analogdog/Source-Sink-Transistor-SST-/Rev6/SST6 bill of materials.xlsx

Component | Package | Value | Manuf | Manuf Part No | Distrib | Distrib Part No | Ref Name | Qty
2N7002 | SOT23 |  | On Semi | 2N7002NCT | Digikey | 2N7002NCT-ND | Q4 | 1
2SD1047 | to247 |  | STMicroelectronics | 2SD1047 | Digikey | 497-11320-5-ND | Q2 | 1
1206YG225ZATEA | SM1206 | 0.1uF | Kemet | C1206C104K3RACTU | Digikey | 399-8140-1-ND | C2 C3 C4 | 3
AAVID_HS_TO220 | SK129 |  | AAvid | 530002B02500G | Digikey | HS380-ND | HS1 | 1
CP1 | DSCV | 10uF | Nichion | RNS1E100MDS1 | Digikey | 493-14240-ND | C1 | 1
DG449 | SM |  | Vishay | DG449DS-T1-E3CT | Digikey | DG449DS-T1-E3CT-ND | U2 U3 | 2
IXDD604 | SM |  | IXYS | IXDD PI SIA | Digikey | CLA333-ND | U1 | 1
Molex 44068-06 | MISC |  | Molex | 440680002 | Digikey | 1727-2692-1-ND | J1 | 1
PBSS4041SPN | SOL |  | Nexperia | PBSS4041SPN,115 | Digikey | 1727-5110-1-ND | Q3 | 1
PMEG100V080 | SM |  | Nexperia | PMEG100V080 | Digikey | 1727-2692-1-ND | D1 D2 | 2
R SM1206 | SM | 10K | Stackpole | RMCF1210JT10K0CT | Digikey | RMCF1210JT10K0CT-ND | R2 R3 R4 | 3
R SM1206 | SM | 470 | Stackpole | RMCF1210JT470RCT | Digikey | RMCF1210JT470RCT-ND | R1 | 1
si4564DYPP | SOL |  | Vishay Siliconix | SI4564DY-T1-GE3CT-ND | Digikey | SI4564DY-T1-GE3CT-ND | Q1 | 1
 |  |  |  |  |  |  |  | 19
PCB Artist Bill of Materials is provided for reference only and must be verified by the user.
