analogdog/Source-Sink-Transistor-SST-/Rev6/pdf/Bottom PCB SST6.pdf

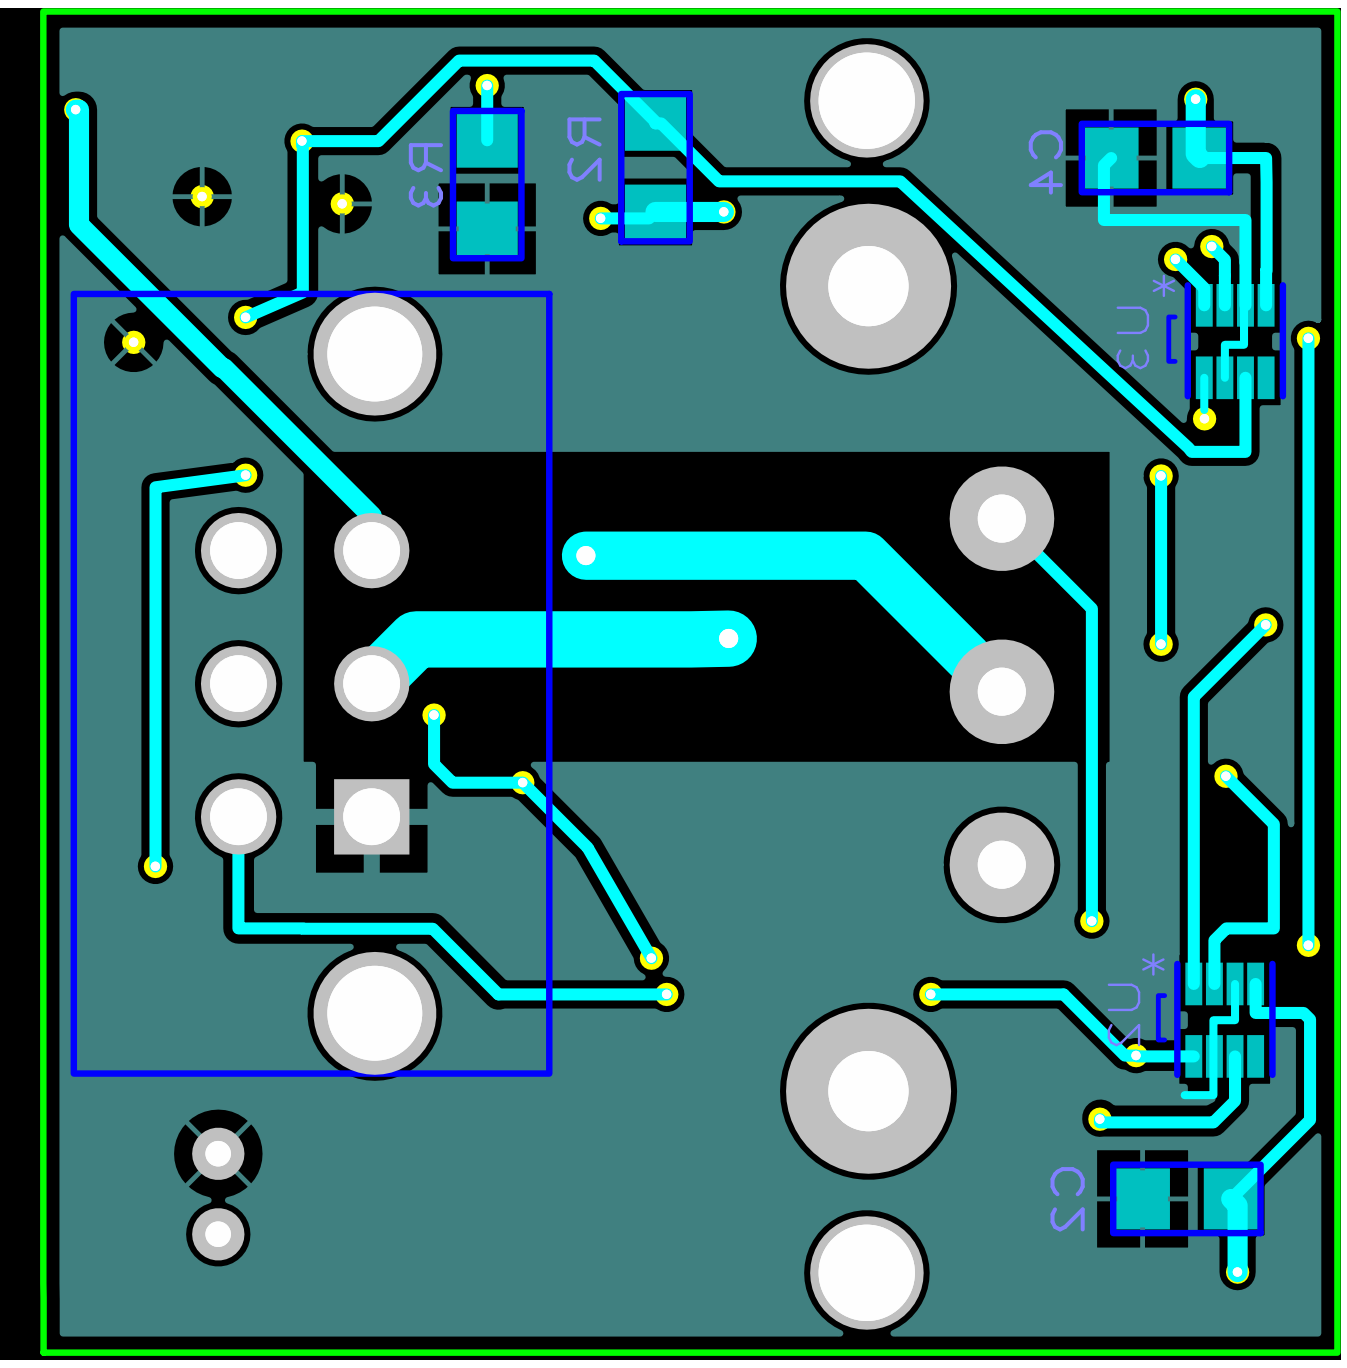
[picture p1: page 1]
