analogdog/Source-Sink-Transistor-SST-/Rev6/pdf/Top PCB SST6.pdf

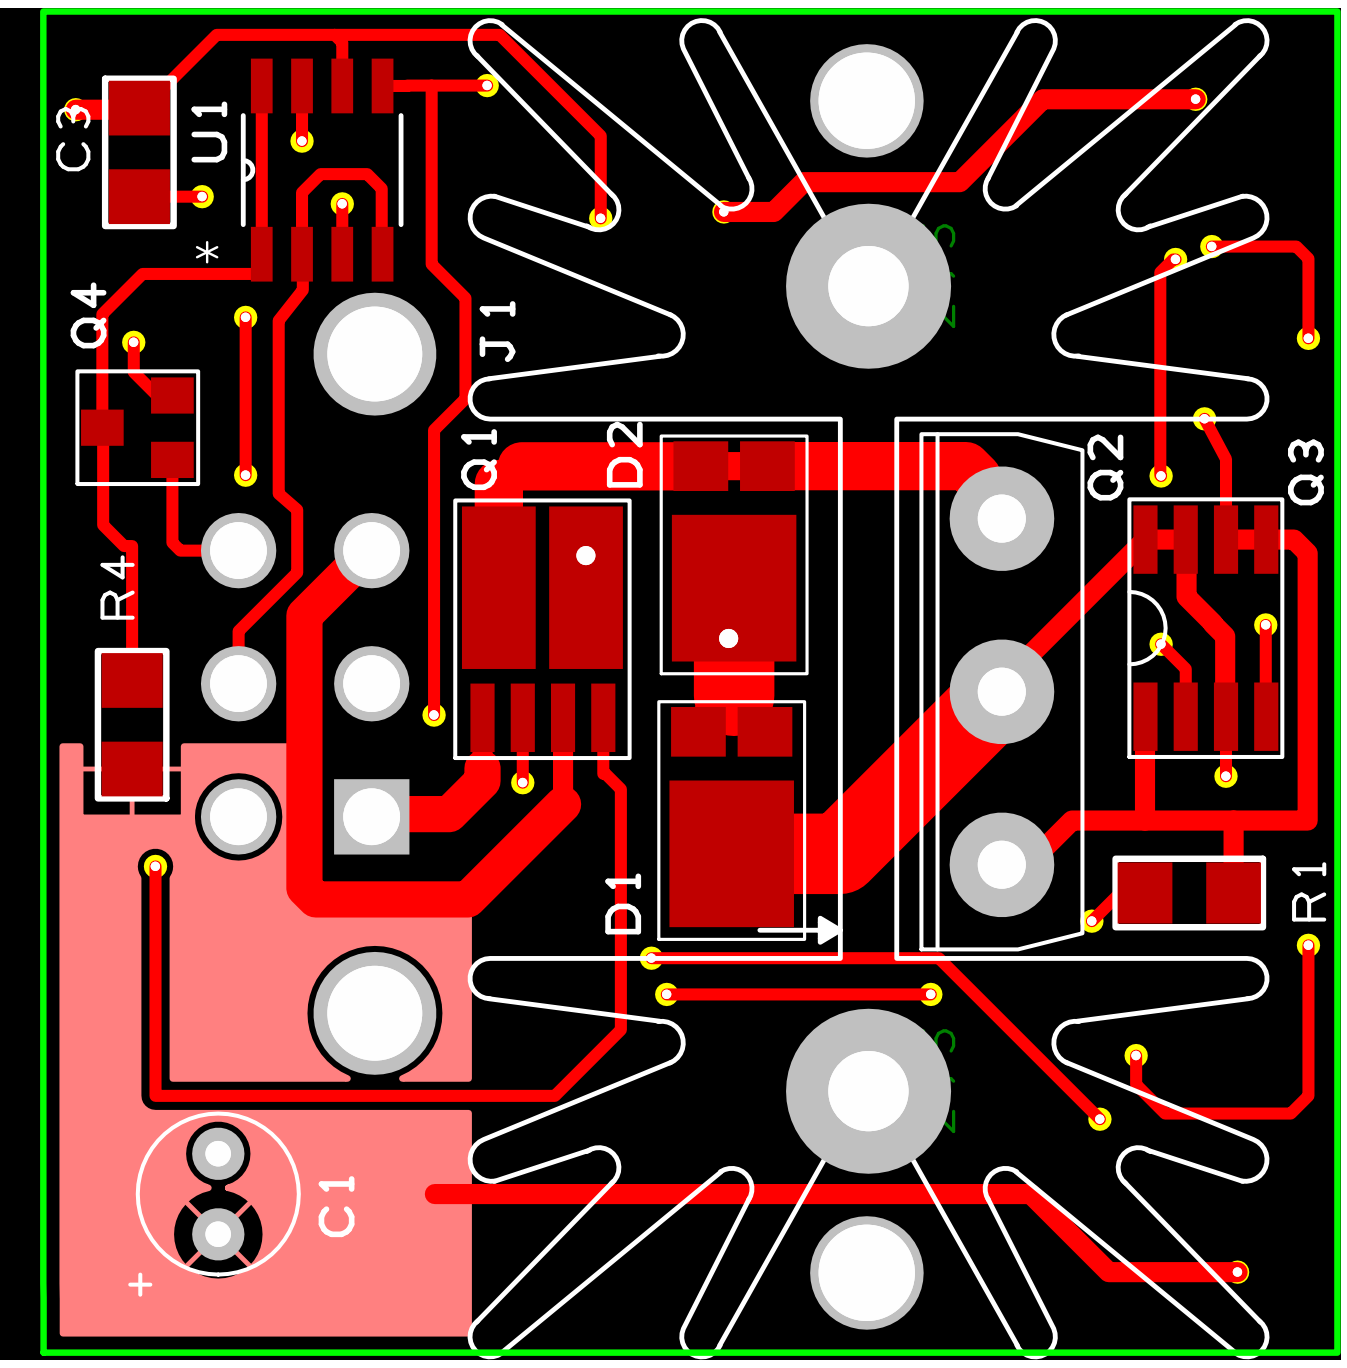
[picture p2: page 1]
