analogdog/Source-Sink-Transistor-SST-/Rev6/pdf/SST6.pdf

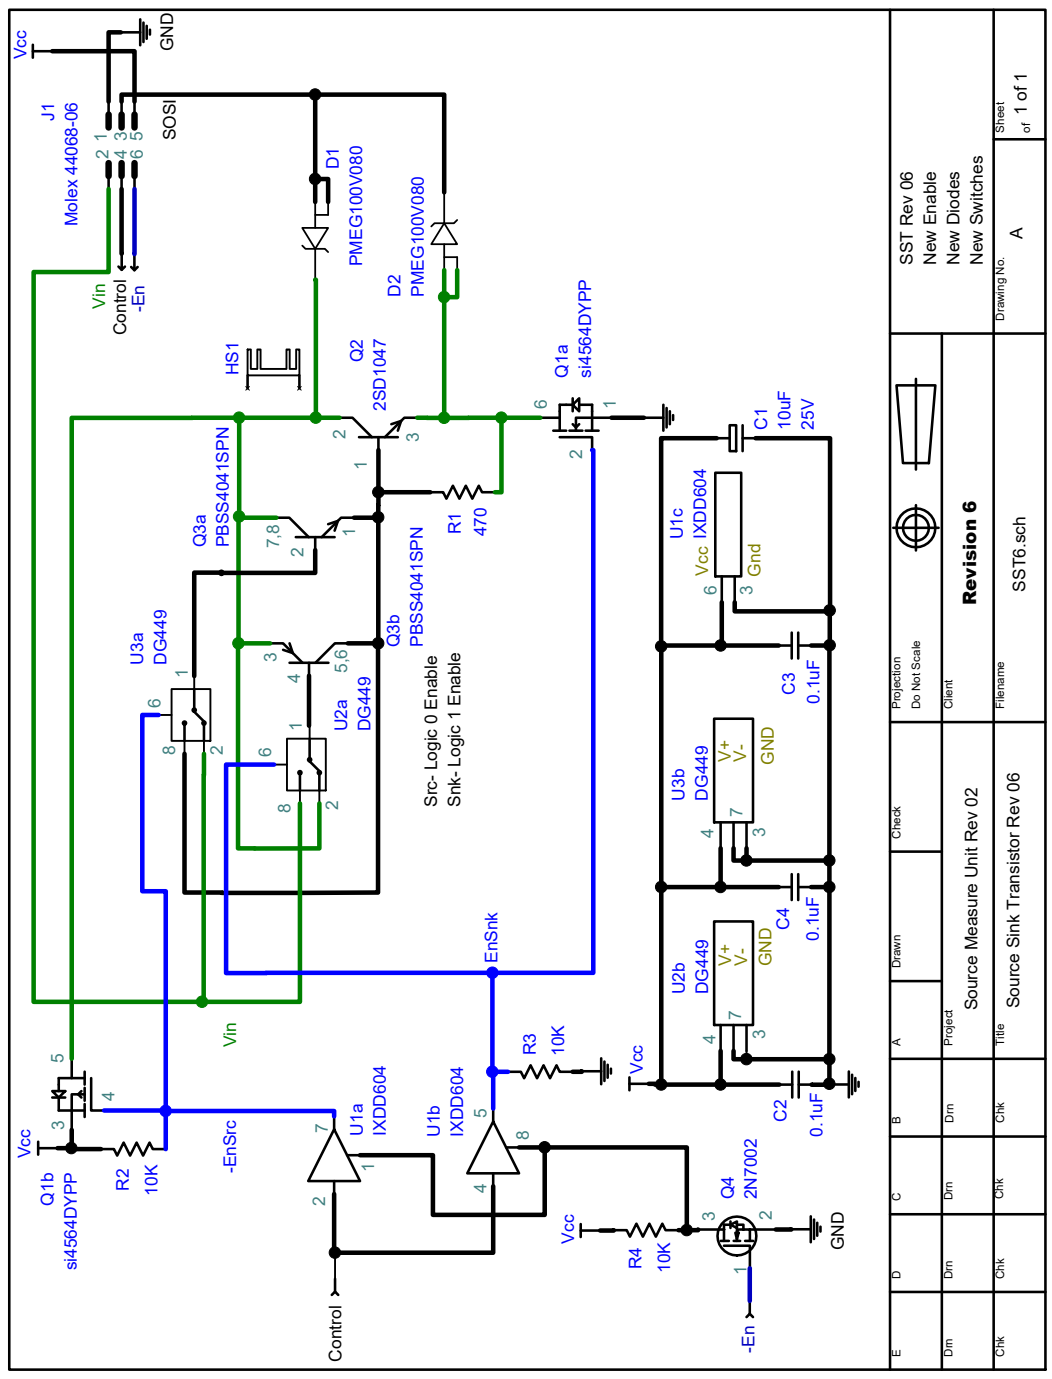
[picture p3: page 1]

Filename Drawing No. Sheet

Source Sink Transistor Rev 06

Source Measure Unit Rev 02

Drn Drn

Chk Chk
