analogdog/Source-Sink-Transistor-SST-/Rev4/pdf/SST4 PCB Bot.pdf

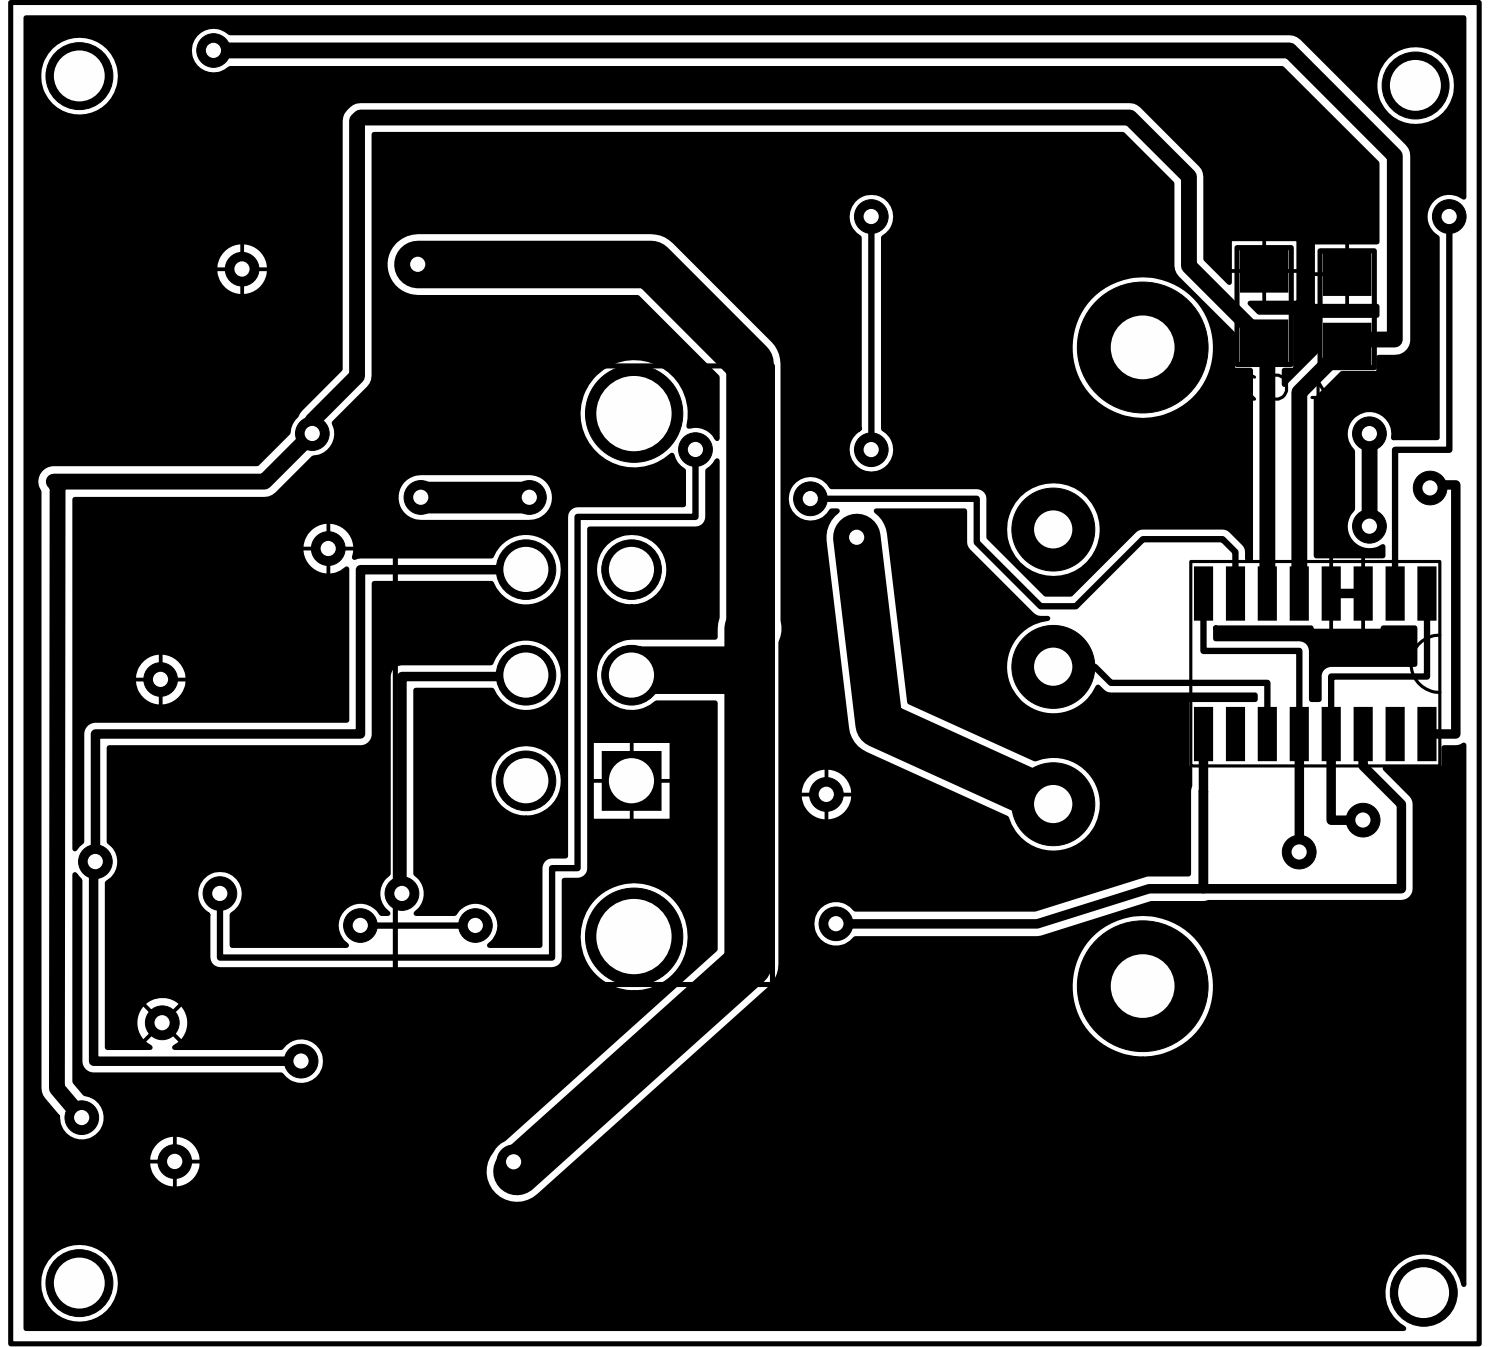
[picture p4: page 1]
