analogdog/Source-Sink-Transistor-SST-/Rev4/pdf/SST4 PCB Top.pdf

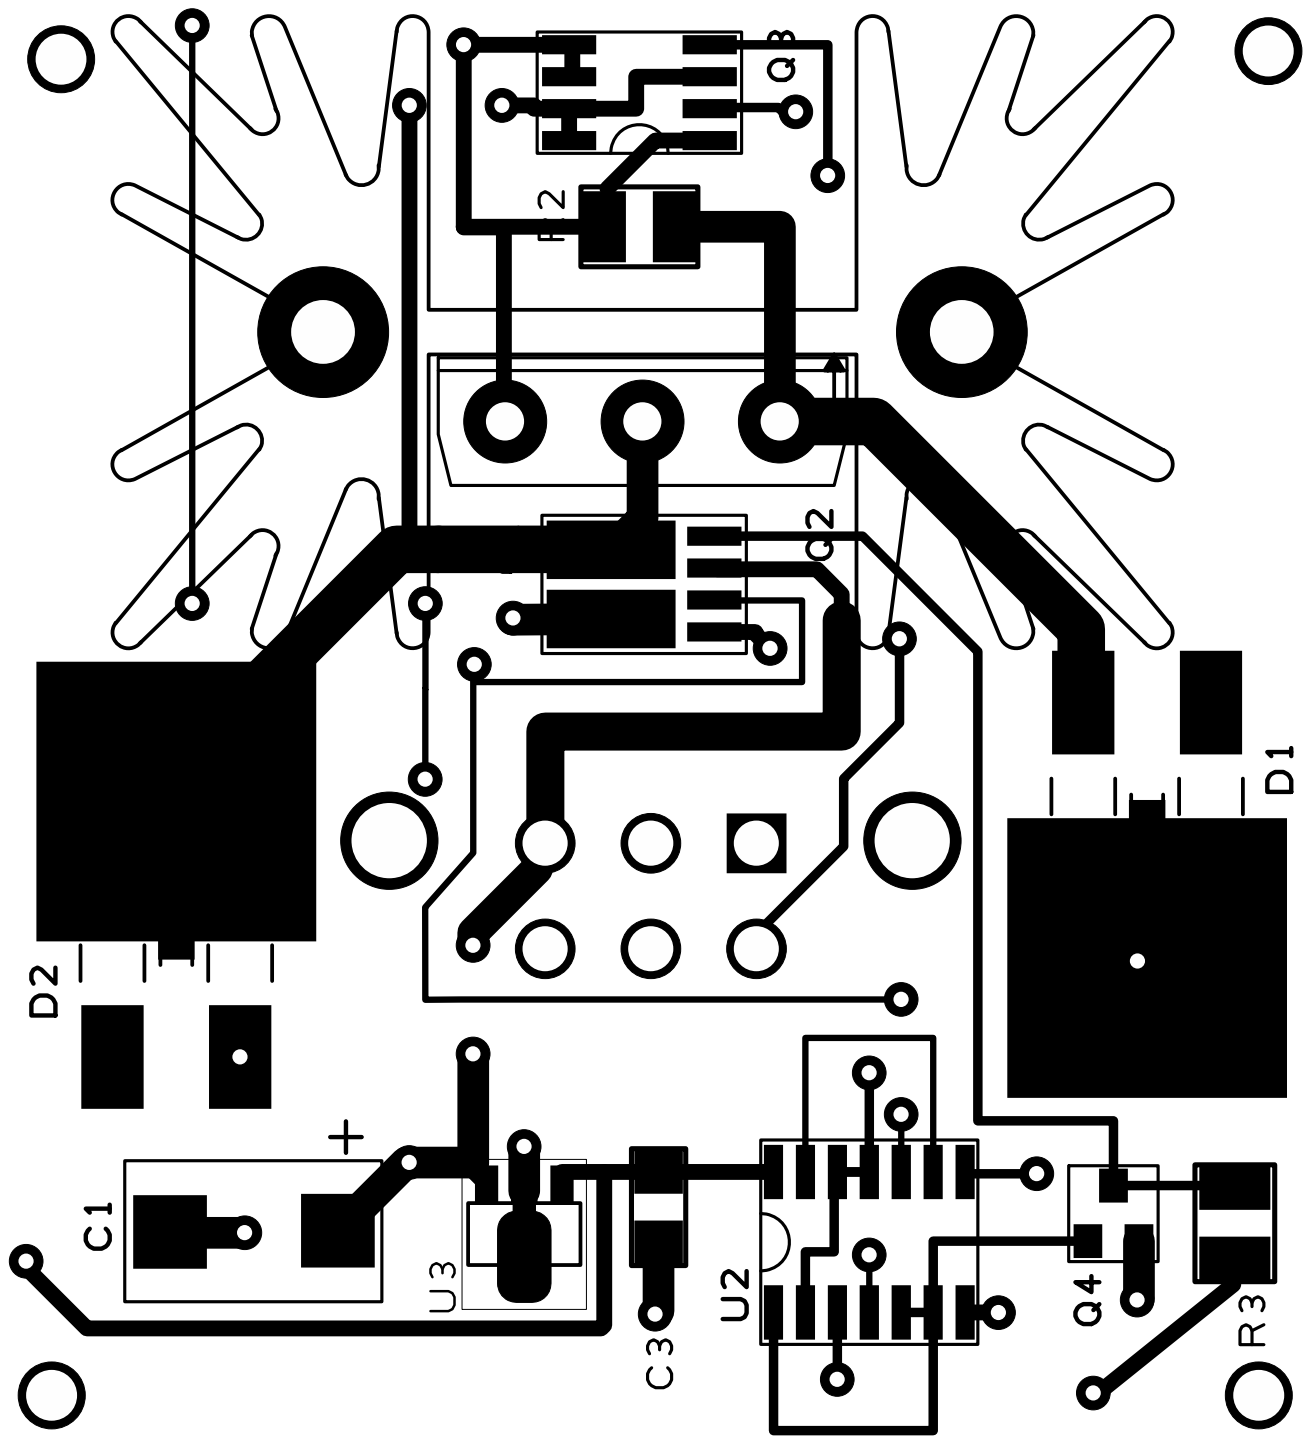
[picture p5: page 1]
