analogdog/Source-Sink-Transistor-SST-/Rev4/pdf/SST4.pdf

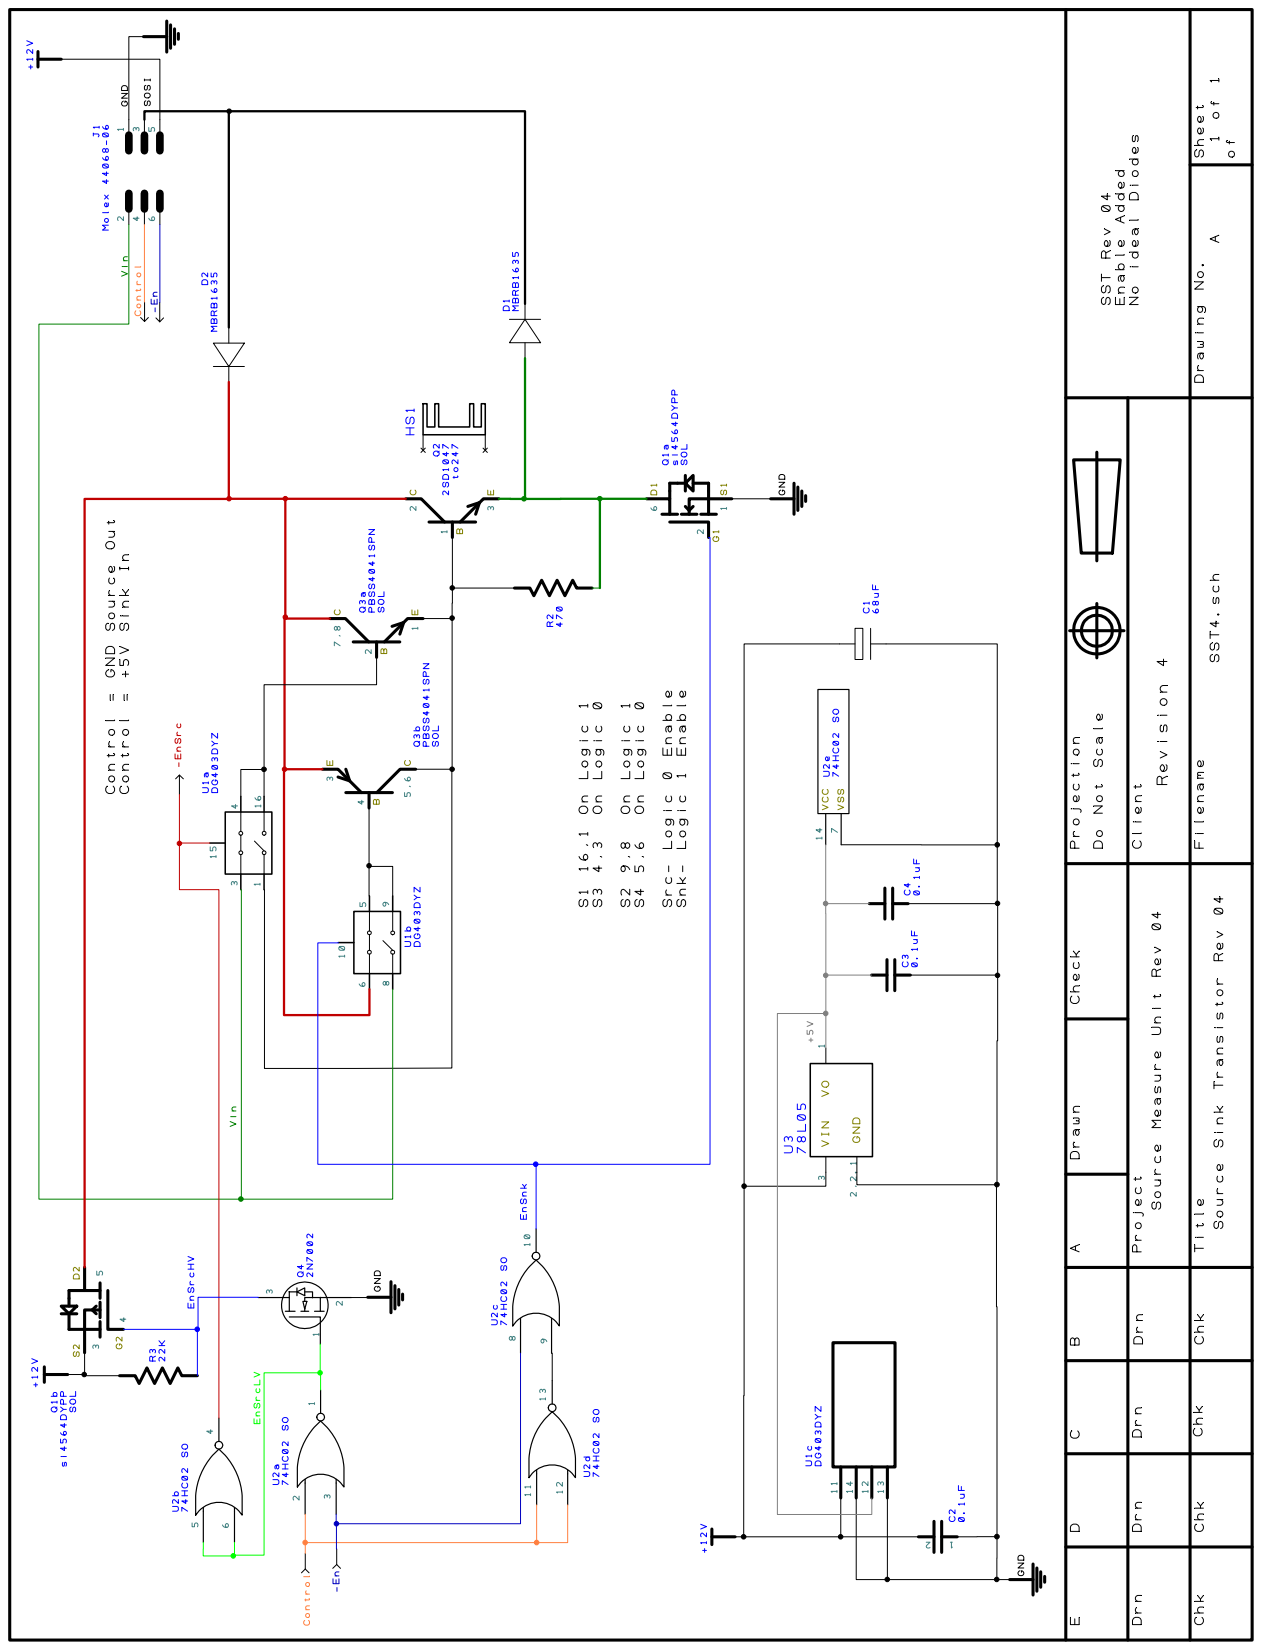
[picture p6: page 1]
