analogdog/Source-Sink-Transistor-SST-/(list of files, drawings)

Other design files:
Rev4/SST4.pcb
Rev4/~SST4.pcb
Rev6/SST6.pcb
Rev6/~SST6.pcb
