analogdog/Source-Sink-Transistor-SST-/How to Install PCB Artist.md

# How to Install PCB Artist
PCB Artist runs on PCs using Windows 7 or later. To view the CAD files, download and install PCB Artist from the following link:
https://www.4pcb.com/free-pcb-layout-software/
Copy the library files from the PCB Artist Library folder here to the folder on your PC where PCB Artist installed its libraries. Default location is:
C:\Users\Public\Documents\PCB Artist\Library

# Note: Future Revisions for the SST will be released in KiCad Version 5 or later.
