analogdog/Source-Sink-Transistor-SST-/(threads)

Thread 1 (2017-11-09):

Preliminary Testing

analogdog, 2017-11-09:
SST Rev 4 - one board has been assembled and tested. Basic functionality has been confimed. Voltage Source, Voltage Sink, Current Source and Current Sink all work.
