analogdog/Source-Sink-Transistor-SST-/(commit log)

2017-12-20 Add files via upload
    SST description includes schematic and PCB layout.
2020-09-11 Reorganize and add Rev 4 PCB files
    [SST Rev4 BOM.xlsx, SST4.pcb, SST4.sch, ~SST4.pcb, ~SST4.sch]
2020-09-11 added Rev 6 to project
    [SST6 bill of materials.xlsx, SST6.pcb, SST6.sch, ~SST6.pcb, ~SST6.sch]
2020-09-13 Added pdf files to Rev 6
    [SST4.pcb, SST4.sch]
2020-09-13 Added PCB Artist CAD Library files
2020-09-17 Create How to Install PCB Artist.md
